Kappaccinoh/LaundroBot/LaundroBot/laundrobot-telegram-main/README.md

# laundrobot-telegram
Telegram Bot code for laundrobot AY23/24 - main bot logic is found in bot.py

Useful materials:
https://t.me/pythontelegrambotgroup (Search for messages sent by @limpotato)
