Kappaccinoh/LaundroBot/(commit log)

2024-01-11 Add arduino code for wifi and POST request
2024-02-28 updated arduino code and laundrobot code
2024-02-29 Update lightsensor.ino
    Temporary fix
    1. removed backend check because that wasn't working
    2. changed timer value to be slightly more accurate
    [lightsensor.ino]
